wagiminator/ATtiny412-USB-PD-Inverter/documentation/USB_PD_Inverter_scope2.jpg

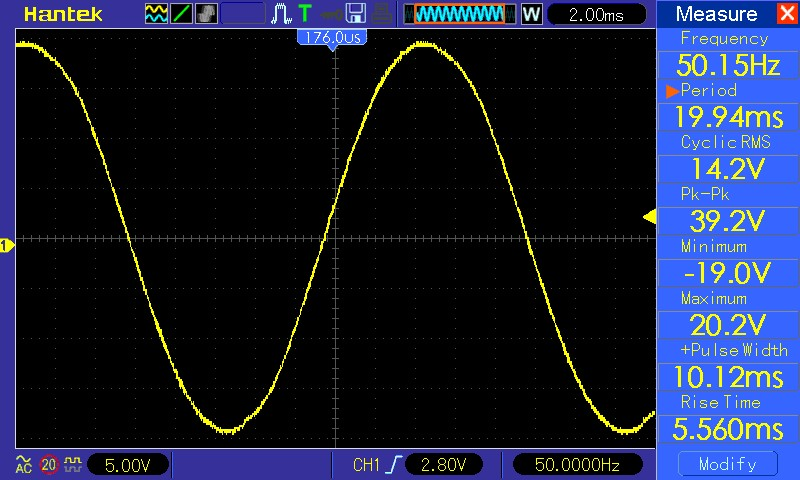
documentation/USB_PD_Inverter_scope2.jpg
