wagiminator/ATtiny412-USB-PD-Inverter/documentation/USB_PD_Inverter_scope8.jpg

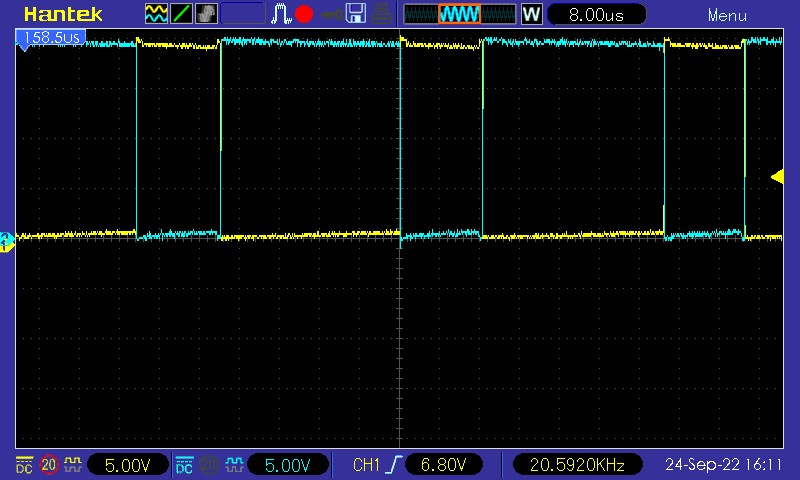
documentation/USB_PD_Inverter_scope8.jpg
