wagiminator/ATtiny412-USB-PD-Inverter/hardware/USB_PD_Inverter_BOM.tsv

ID | Name | Designator | Footprint | Quantity | Manufacturer Part | Manufacturer | Supplier | Supplier Part | Price
1 | 100n | C1,C6,C9 | C_0603 | 3 | CC0603KRX7R9BB104 | YAGEO | LCSC | C14663 | 0.002
2 | 10u | C2 | C_0603 | 1 | CL10A106KP8NNNC | SAMSUNG | LCSC | C19702 | 0.003
3 | 1u | C3 | C_0603 | 1 | CL10A105KB8NNNC | SAMSUNG | LCSC | C15849 | 0.003
4 | 220u | C4,C5 | CAP_SMD_10MM | 2 | RT1H221M1010 | ROQANG | LCSC | C280410 | 0.115
5 | 470u | C7 | CAP_SMD_10MM | 1 | RT1V471M1010 | ROQANG | LCSC | C280413 | 0.113
6 | 330n | C8 | C_0603 | 1 | 0603B334K250NT | FH | LCSC | C1615 | 0.012
7 | GT-USB-7010ASV | CN1 | USB-C-7010ASV | 1 | GT-USB-7010ASV | G-Switch(品赞) | LCSC | C2988369 | 0.085
8 | KF301-2P | CN2,CN3 | KF301-2P | 2 | KF301-5.0-2P | Cixi Kefa Elec | LCSC | C474881 | 0.109
9 | UPDI | CN4 | 210S-3X1/2.54 | 1 | Header2.54mm 1*3P | BOOMELE | LCSC | C49257 | 0.015
10 | 220uH | L1,L2 | IND-SMD_L12.3 | 2 | CYH127-220UH | SHOU HAN(首韩) | LCSC | C2929507 | 0.243
11 | PWR | LED1 | LED_0603_S | 1 | 19-217/GHC-YR1S2/3T | EVERLIGHT | LCSC | C72043 | 0.028
12 | 10k | R1,R3,R4 | 0603 | 3 | 0603WAF1002T5E | UniOhm | LCSC | C25804
13 | R200 | R2 | 2512 | 1 | 25121WF200LT4E | UniOhm | LCSC | C83749 | 0.038
14 | 1k | R5,R6 | 0603 | 2 | 0603WAF1001T5E | UniOhm | LCSC | C21190
15 | DSHP03TS-S | SW1 | SW-SMD_DIP3 | 1 | DSHP03TS-S | XKB Enterprise | LCSC | C319051 | 0.543
16 | ATTINY412-SSN | U1 | SOP-8_150MIL | 1 | ATTINY412-SSN | MICROCHIP(美国微芯) | LCSC | C1338223 | 0.577
17 | CH224K | U2 | ESSOP-10-EP | 1 | CH224K | WCH |  | CH224K
18 | DRV8870DDAR | U3 | SOP-8_EP_150MIL | 1 | DRV8870DDAR | TI | LCSC | C86590 | 0.641
19 | 78L05 | U4 | SOT-89-3_BR | 1 | UMW78L05 | Youtai Semiconductor Co., Ltd. | LCSC | C347258 | 0.034
