wagiminator/ATtiny412-USB-PD-Inverter/hardware/USB_PD_Inverter_schematic.pdf

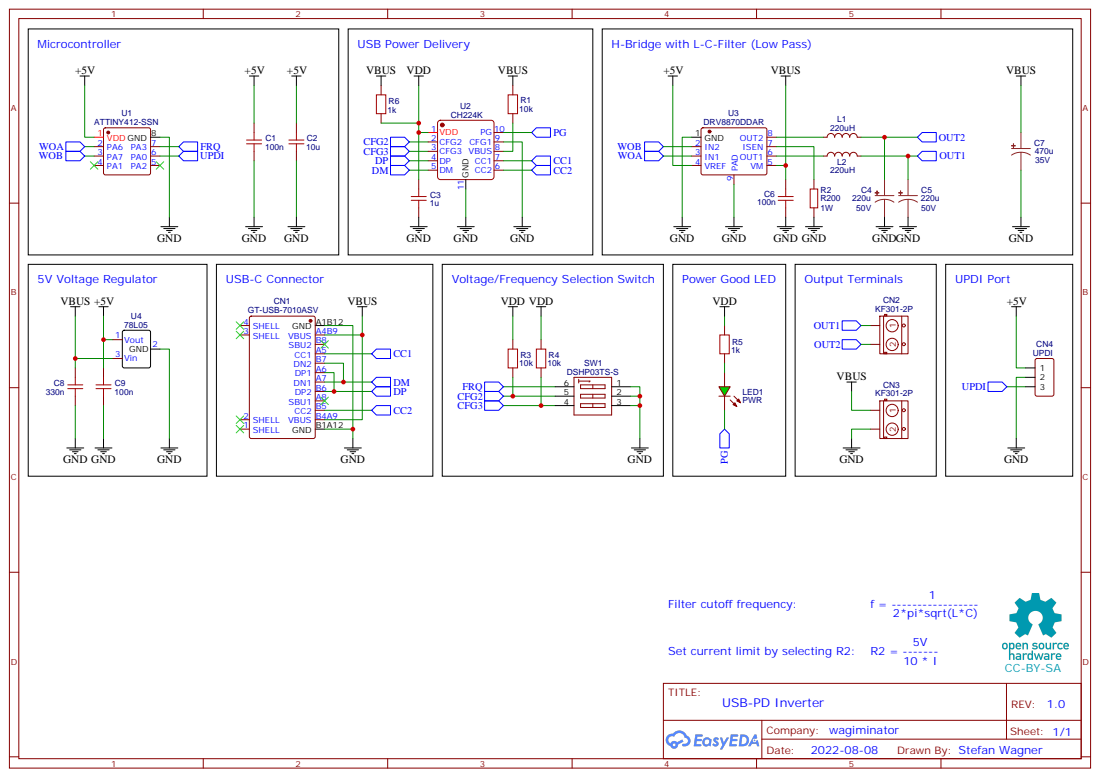
[picture p15: page 1]

H-Bridge with L-C-Filter (Low Pass)

Set current limit by selecting R2:

Drawn By: Stefan Wagner
