wagiminator/ATtiny412-USB-PD-Inverter/(threads)

Thread 1 (2025-09-14):

Question about dead time

positron96, 2025-09-14:
Hi! First of all, thanks for a nicely documented projects. It is very educational and can be used as a reference for USB-PD projects.

I have a question. Since there is no "discussions" section, I'll post it here.
You mention that you need to insert dead times to Hbridge input from the MCU, why is that? My understanding is, you need dead time between signals for individual MOSFETs of a single half-bridge to avoid shoot-through. I haven't looked at the datasheet, but all TI h-bridges that I've seen do that internally, and since you control half-bridge with one pin, you have no control over it anyway.
With dead-time between half-bridge you only make sure they don't enable at the same time, but since you filter PWM out, the load doesn't see it much anyway.
Dead time also limits your max PWM fillrate (which is not 100% but 255/295, I think)

positron96, 2025-09-14:
Thank you for explanation!
